ciborg971/Devterm-Custom-EXT/boardTop.PNG

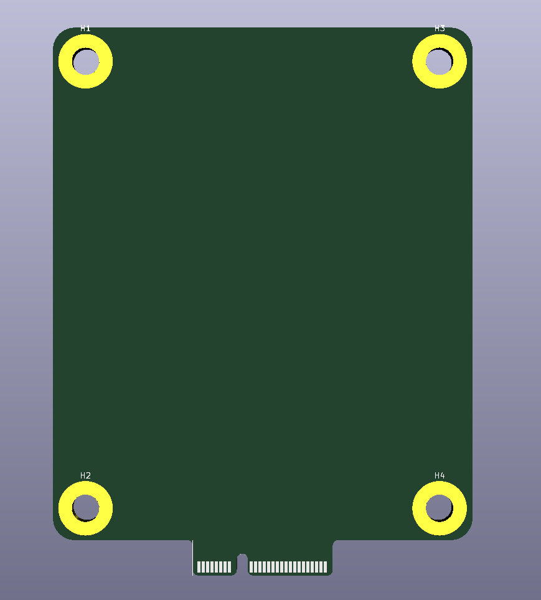
boardTop.PNG
