ciborg971/Devterm-Custom-EXT/DOC/6f06c1a4455e24246e7014514f4f96971abfcb94.png

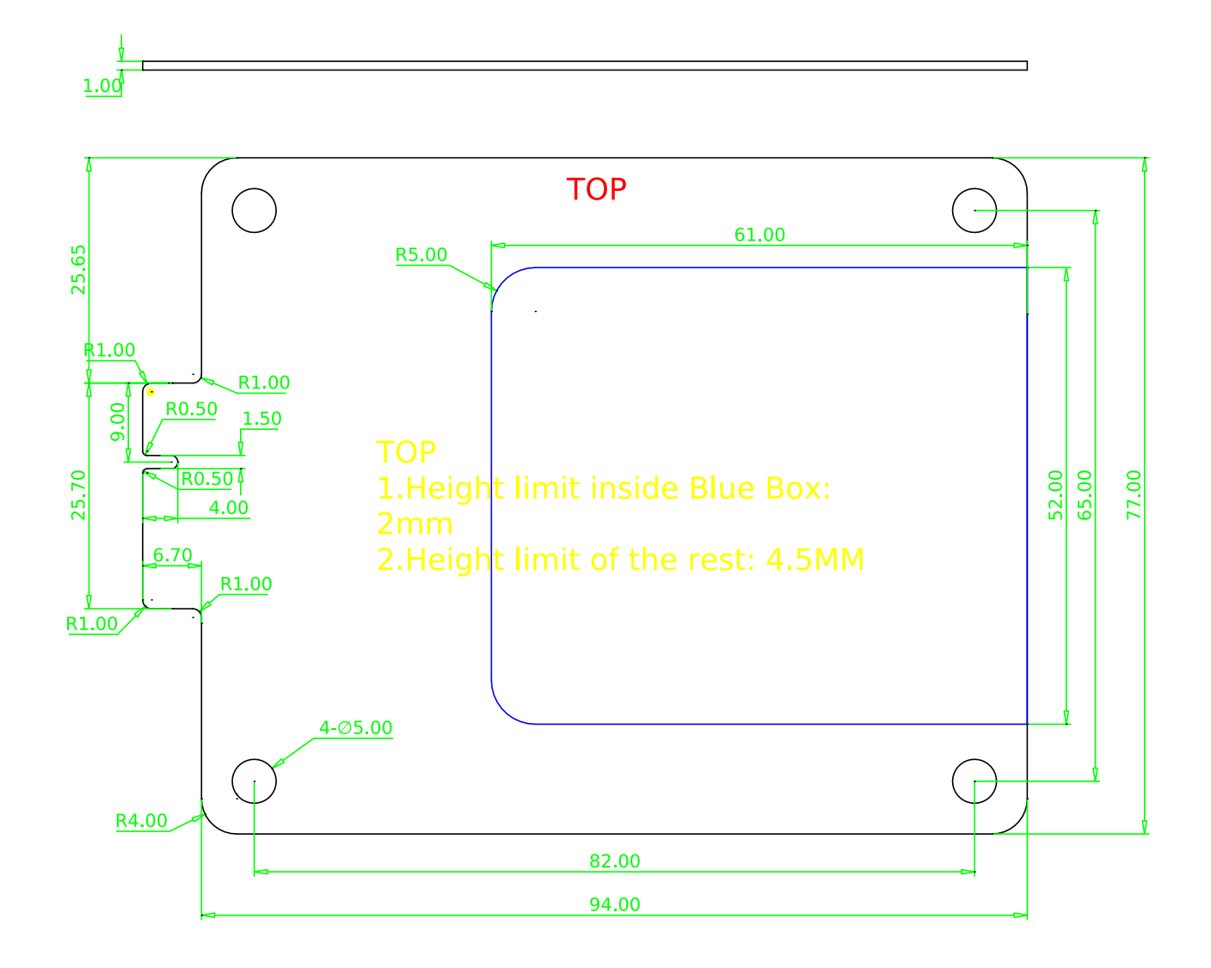
DOC/6f06c1a4455e24246e7014514f4f96971abfcb94.png
