ciborg971/Devterm-Custom-EXT/DOC/45b9404a094dcbd29ee0b0e9fbe9222e9d59b63e.png

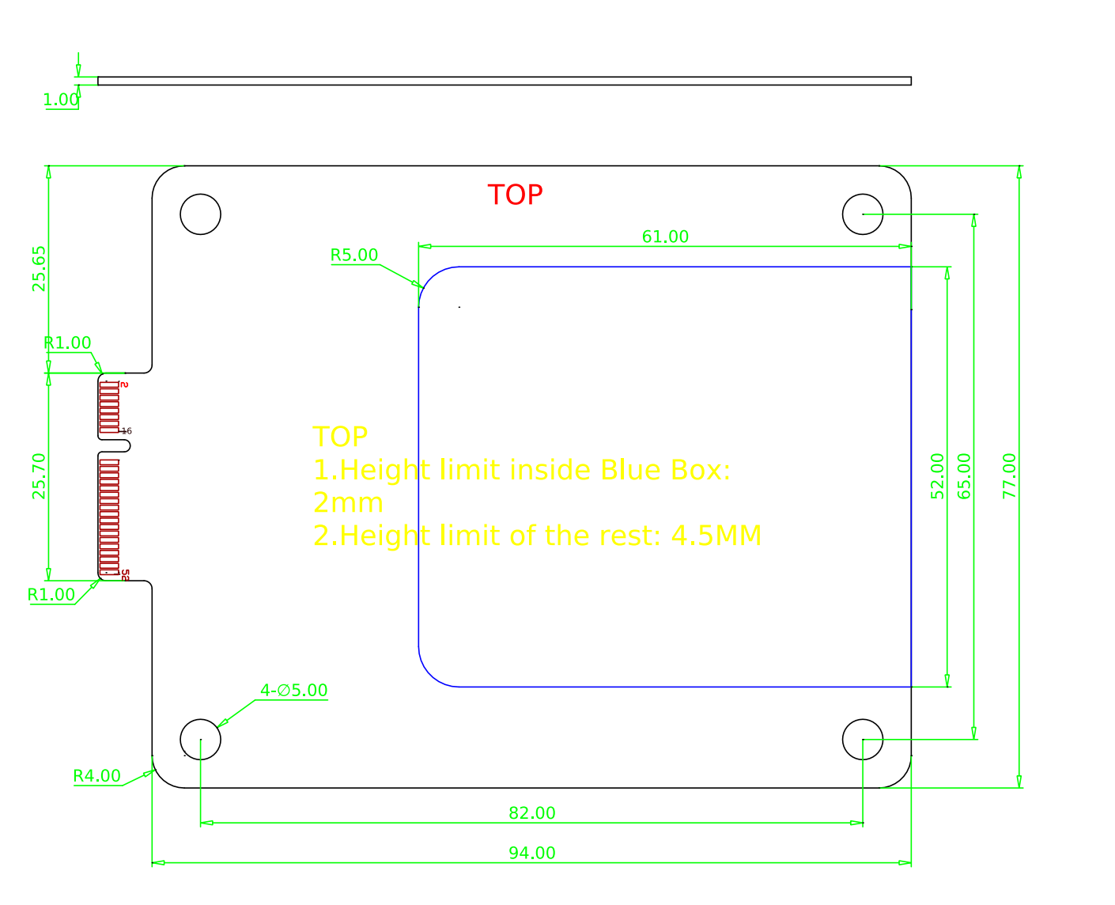
DOC/45b9404a094dcbd29ee0b0e9fbe9222e9d59b63e.png
