ciborg971/Devterm-Custom-EXT/DOC/df499cc8dd050f36cda59deae903229f311af123.png

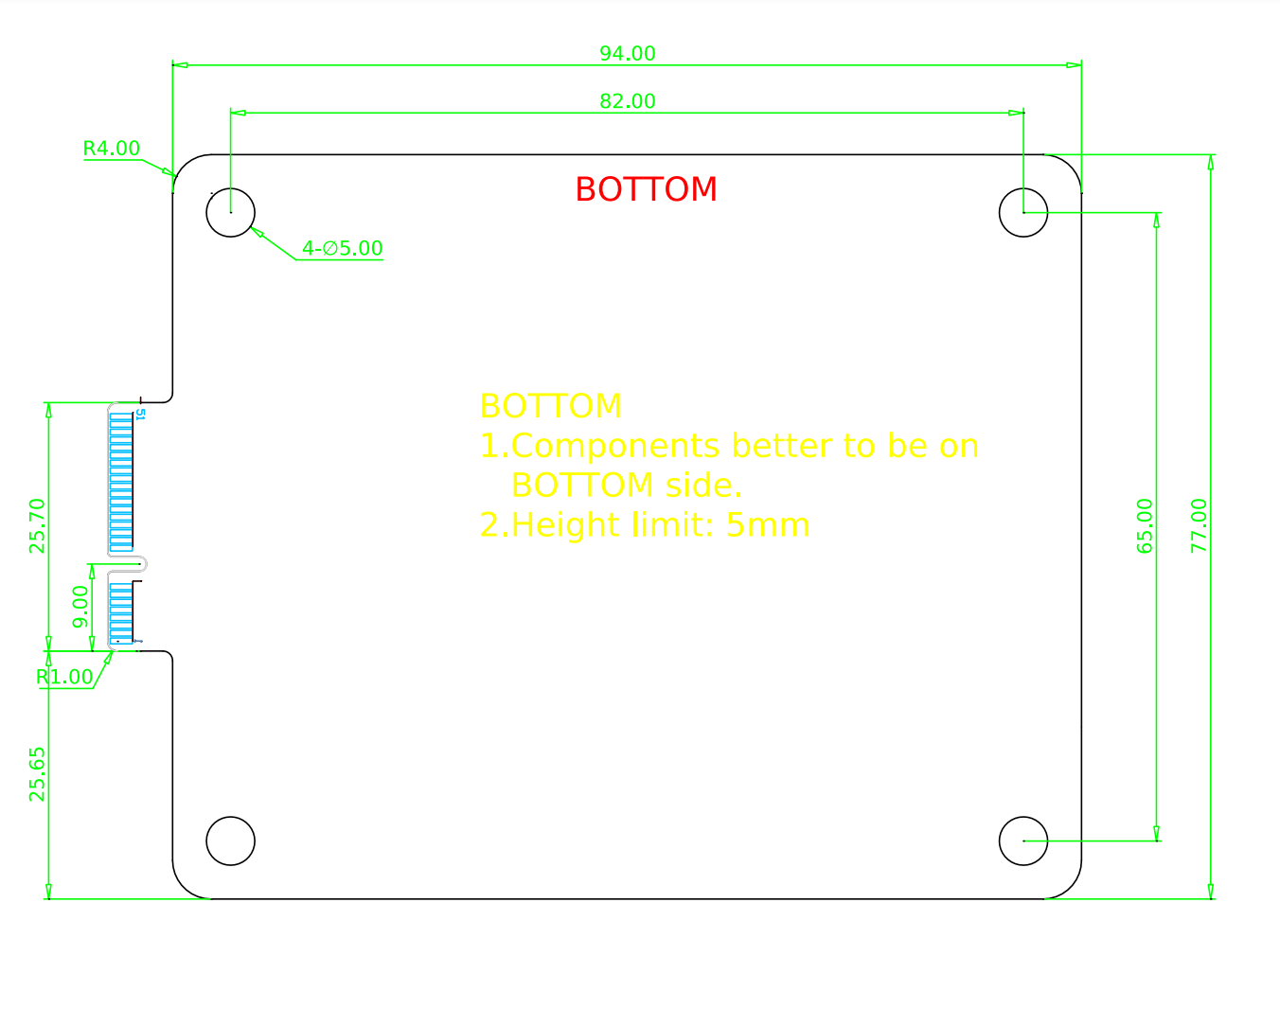
DOC/df499cc8dd050f36cda59deae903229f311af123.png
