ciborg971/Devterm-Custom-EXT/DCEXT/output/Schematic.pdf

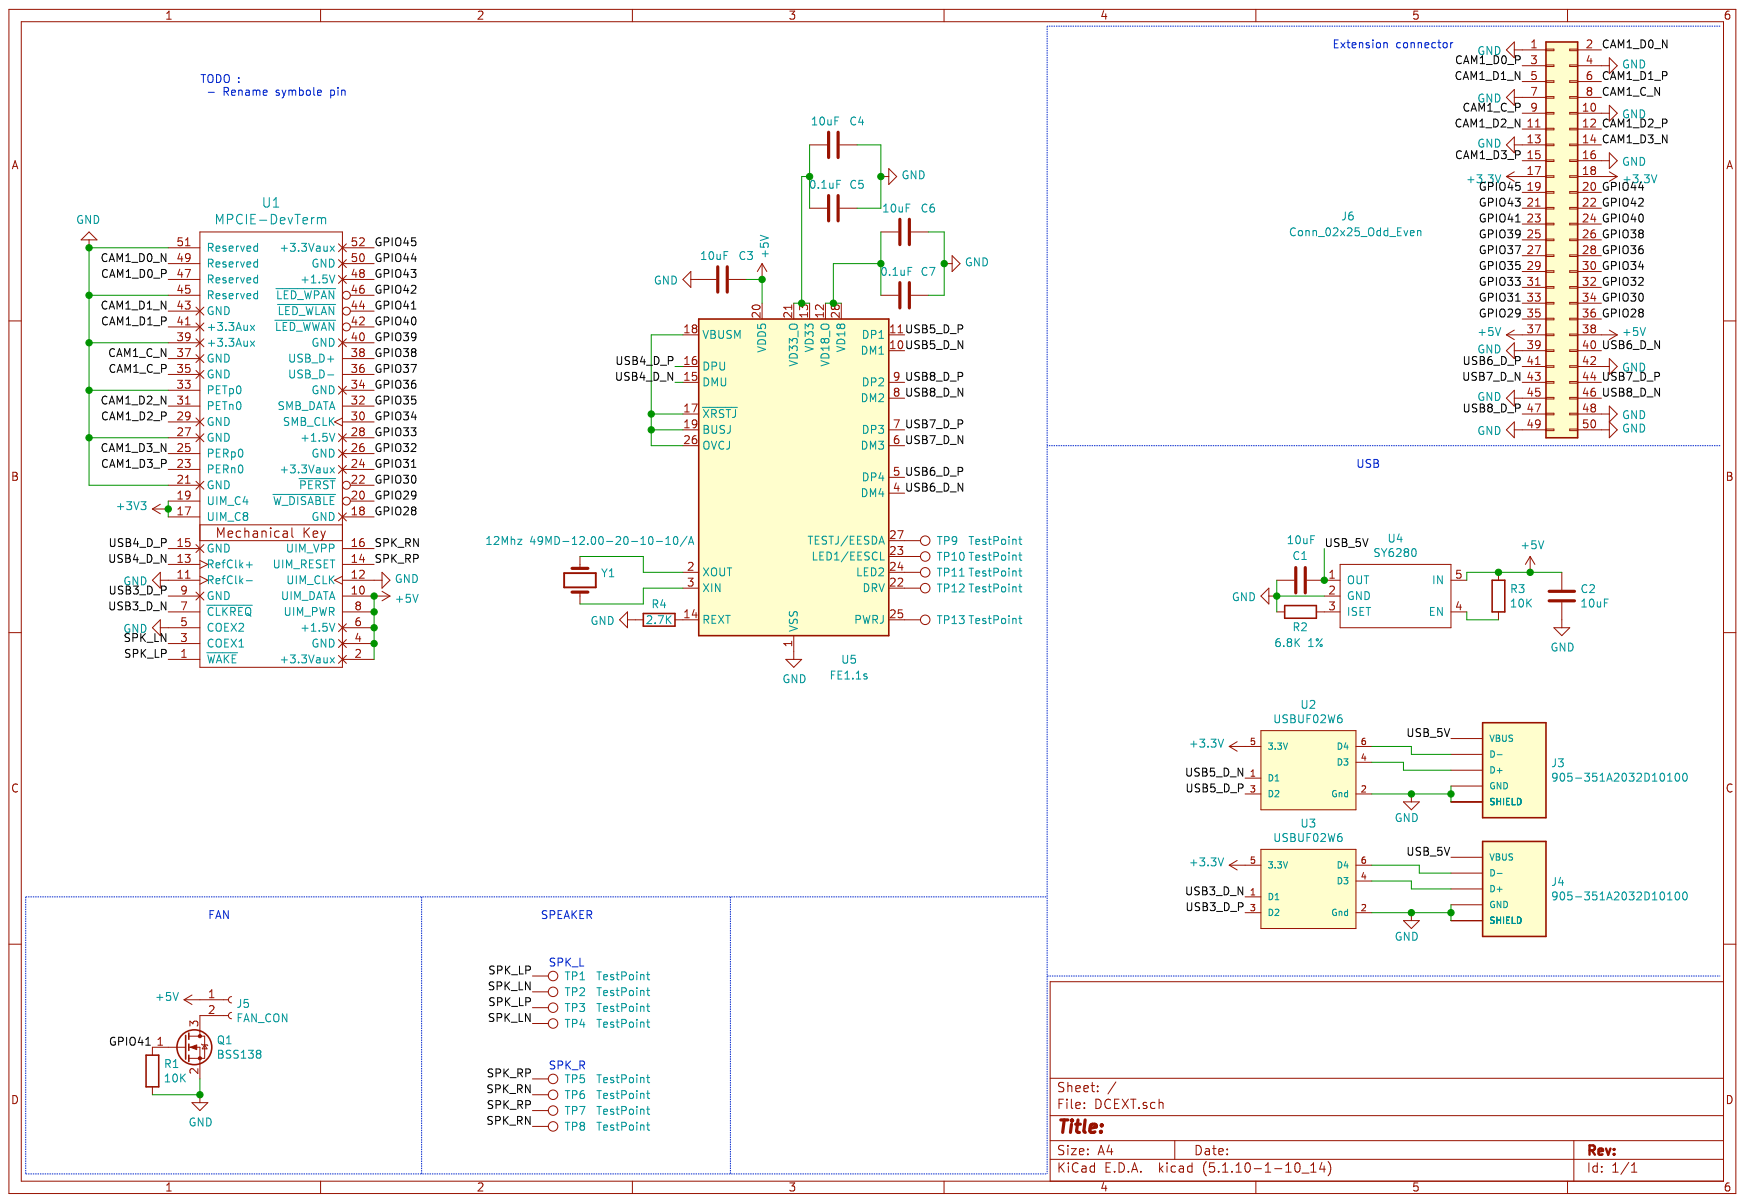
[picture p5: page 1]
