ciborg971/Devterm-Custom-EXT/DCEXT/DCEXT.kicad_pcb

## KiCad design DCEXT/DCEXT.kicad_pcb (2021-12-01)

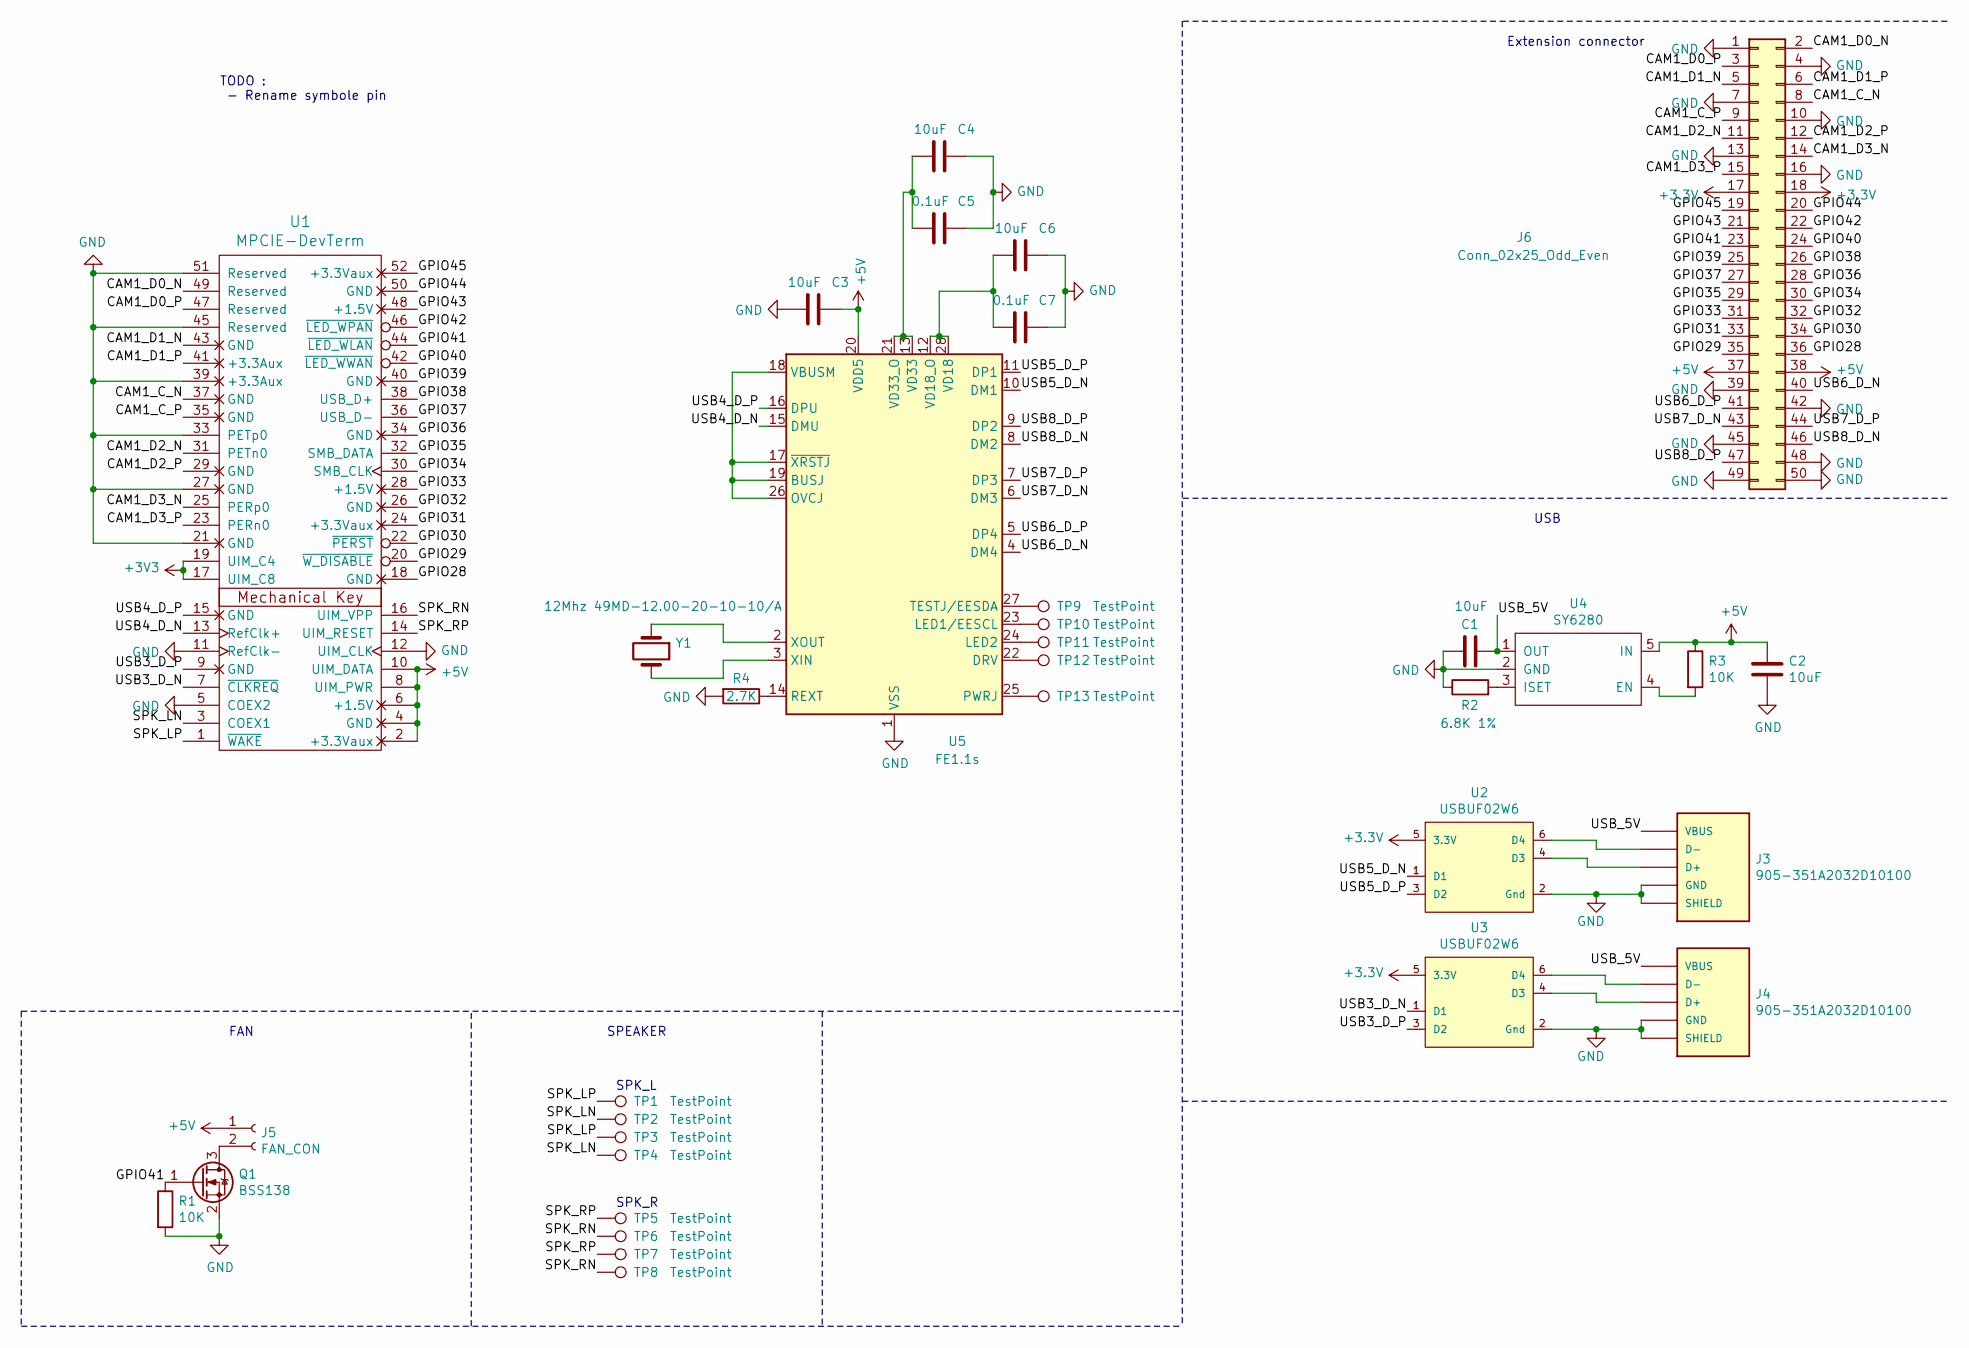
[picture p6: schematic DCEXT.sch]

Parts:
C1, C2, C3, C4, C6: 10uF; C_0402_1005Metric; LCSC C2846677
C5, C7: 0.1uF; C_0402_1005Metric; LCSC C41851
J3, J4: 905-351A2032D10100; USB-A-TH_USB-M-55-F; LCSC C42623
J5: FAN_CON; JST_PH_S2B-PH-K_1x02_P2.00mm_Horizontal; LCSC C160237
J6: Conn_02x25_Odd_Even; Hirose_FH12-50S-0.5SH_1x50-1MP_P0.50mm_Horizontal; LCSC C11098
Q1: BSS138; SOT-23; LCSC C427380
R1, R3: 10K; R_0402_1005Metric; LCSC C258091
R2: 6.8K 1%; R_0402_1005Metric; LCSC C208929
R4: 2.7K; R_0402_1005Metric; LCSC C168220
TP1, TP2, TP3, TP4, TP5, TP6, TP7, TP8: TestPoint; TestPoint_Pad_3.0x3.0mm
TP9, TP10, TP11, TP12, TP13: TestPoint; TestPoint_Pad_1.5x1.5mm
U1: MPCIE-DevTerm; devtermMPCIE
U2, U3: USBUF02W6; ST_Microelectronics-USBUF02W6-0; mouser part number 511-USBUF02W6; digikey description RC (Pi) EMI Filter 2nd Order Low Pass 2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
U4: SY6280; SOT-23-5_HandSoldering; LCSC C55136
U5: FE1.1s; SSOP-28_3.9x9.9mm_P0.635mm; LCSC C9359
Y1: 12Mhz 49MD-12.00-20-10-10/A; Crystal_SMD_HC49-SD; LCSC C240992

Connections:
+5V: C2.1, C3.1, J5.1, J6.37, J6.38, R3.1, U1.2 (+3.3Vaux), U1.4 (GND), U1.6 (+1.5V), U1.8 (UIM_PWR), U1.10 (UIM_DATA), U4.5 (IN), U5.20 (VDD5)
/CAM1_C_N: J6.8, U1.37 (GND)
/CAM1_C_P: J6.9, U1.35 (GND)
/CAM1_D0_N: J6.2, U1.49 (Reserved)
/CAM1_D0_P: J6.3, U1.47 (Reserved)
/CAM1_D1_N: J6.5, U1.43 (GND)
/CAM1_D1_P: J6.6, U1.41 (+3.3Aux)
/CAM1_D2_N: J6.11, U1.31 (PETn0)
/CAM1_D2_P: J6.12, U1.29 (GND)
/CAM1_D3_N: J6.14, U1.25 (PERp0)
/CAM1_D3_P: J6.15, U1.23 (PERn0)
/GPIO28: J6.36, U1.18 (GND)
/GPIO29: J6.35, U1.20 (~W_DISABLE)
/GPIO30: J6.34, U1.22 (~PERST)
/GPIO31: J6.33, U1.24 (+3.3Vaux)
/GPIO32: J6.32, U1.26 (GND)
/GPIO33: J6.31, U1.28 (+1.5V)
/GPIO34: J6.30, U1.30 (SMB_CLK)
/GPIO35: J6.29, U1.32 (SMB_DATA)
/GPIO36: J6.28, U1.34 (GND)
/GPIO37: J6.27, U1.36 (USB_D-)
/GPIO38: J6.26, U1.38 (USB_D+)
/GPIO39: J6.25, U1.40 (GND)
/GPIO40: J6.24, U1.42 (~LED_WWAN)
/GPIO41: J6.23, Q1.1 (G), R1.1, U1.44 (~LED_WLAN)
/GPIO42: J6.22, U1.46 (~LED_WPAN)
/GPIO43: J6.21, U1.48 (+1.5V)
/GPIO44: J6.20, U1.50 (GND)
/GPIO45: J6.19, U1.52 (+3.3Vaux)
/SPK_LN: TP2.1, TP4.1, U1.3 (COEX1)
/SPK_LP: TP1.1, TP3.1, U1.1 (~WAKE)
/SPK_RN: TP6.1, TP8.1, U1.16 (UIM_VPP)
/SPK_RP: TP5.1, TP7.1, U1.14 (UIM_RESET)
/USB3_D_N: U1.7 (~CLKREQ), U3.1 (D1)
/USB3_D_P: U1.9 (GND), U3.3 (D2)
/USB4_D_N: U1.13 (RefClk+), U5.15 (DMU)
/USB4_D_P: U1.15 (GND), U5.16 (DPU)
/USB5_D_N: U2.1 (D1), U5.10 (DM1)
/USB5_D_P: U2.3 (D2), U5.11 (DP1)
/USB6_D_N: J6.40, U5.4 (DM4)
/USB6_D_P: J6.41, U5.5 (DP4)
/USB7_D_N: J6.43, U5.6 (DM3)
/USB7_D_P: J6.44, U5.7 (DP3)
/USB8_D_N: J6.46, U5.8 (DM2)
/USB8_D_P: J6.47, U5.9 (DP2)
/USB_5V: C1.2, J3.1 (VBUS), J4.1 (VBUS), U4.1 (OUT)
GND: C1.1, C2.2, C3.2, C4.1, C5.1, C6.1, C7.1, J3.4 (GND), J3.5 (SHIELD), J3.6 (SHIELD), J3.7 (SHIELD), J3.8 (SHIELD), J4.4 (GND), J4.5 (SHIELD), J4.6 (SHIELD), J4.7 (SHIELD), J4.8 (SHIELD), J6.1, J6.4, J6.7, J6.10, J6.13, J6.16, J6.39, J6.42, J6.45, J6.48, J6.49, J6.50, Q1.2 (S), R1.2, R2.1, R4.2, U1.5 (COEX2), U1.11 (RefClk-), U1.12 (UIM_CLK), U1.21 (GND), U1.27 (GND), U1.33 (PETp0), U1.39 (+3.3Aux), U1.45 (Reserved), U1.51 (Reserved), U2.2 (Gnd), U3.2 (Gnd), U4.2 (GND), U5.1 (VSS)
unnamed: C4.2, C5.2, U5.13 (VD33), U5.21 (VD33_O)
unnamed: C6.2, C7.2, U5.12 (VD18_O), U5.28 (VD18)
unnamed: J3.2 (D-), U2.6 (D4)
unnamed: J3.3 (D+), U2.4 (D3)
unnamed: J4.2 (D-), U3.6 (D4)
unnamed: J4.3 (D+), U3.4 (D3)
unnamed: J5.2, Q1.3 (D)
unnamed: R2.2, U4.3 (ISET)
unnamed: R3.2, U4.4 (EN)
unnamed: R4.1, U5.14 (REXT)
unnamed: TP9.1, U5.27 (TESTJ/EESDA)
unnamed: TP10.1, U5.23 (LED1/EESCL)
unnamed: TP11.1, U5.24 (LED2)
unnamed: TP12.1, U5.22 (DRV)
unnamed: TP13.1, U5.25 (PWRJ)
unnamed: U5.2 (XOUT), Y1.1
unnamed: U5.3 (XIN), Y1.2
unnamed: U5.17 (~XRSTJ), U5.18 (VBUSM), U5.19 (BUSJ), U5.26 (OVCJ)

Notes on the sheet:
FAN
SPEAKER
USB
TODO : - Rename symbole pin
Extension connector
SPK_L
SPK_R

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
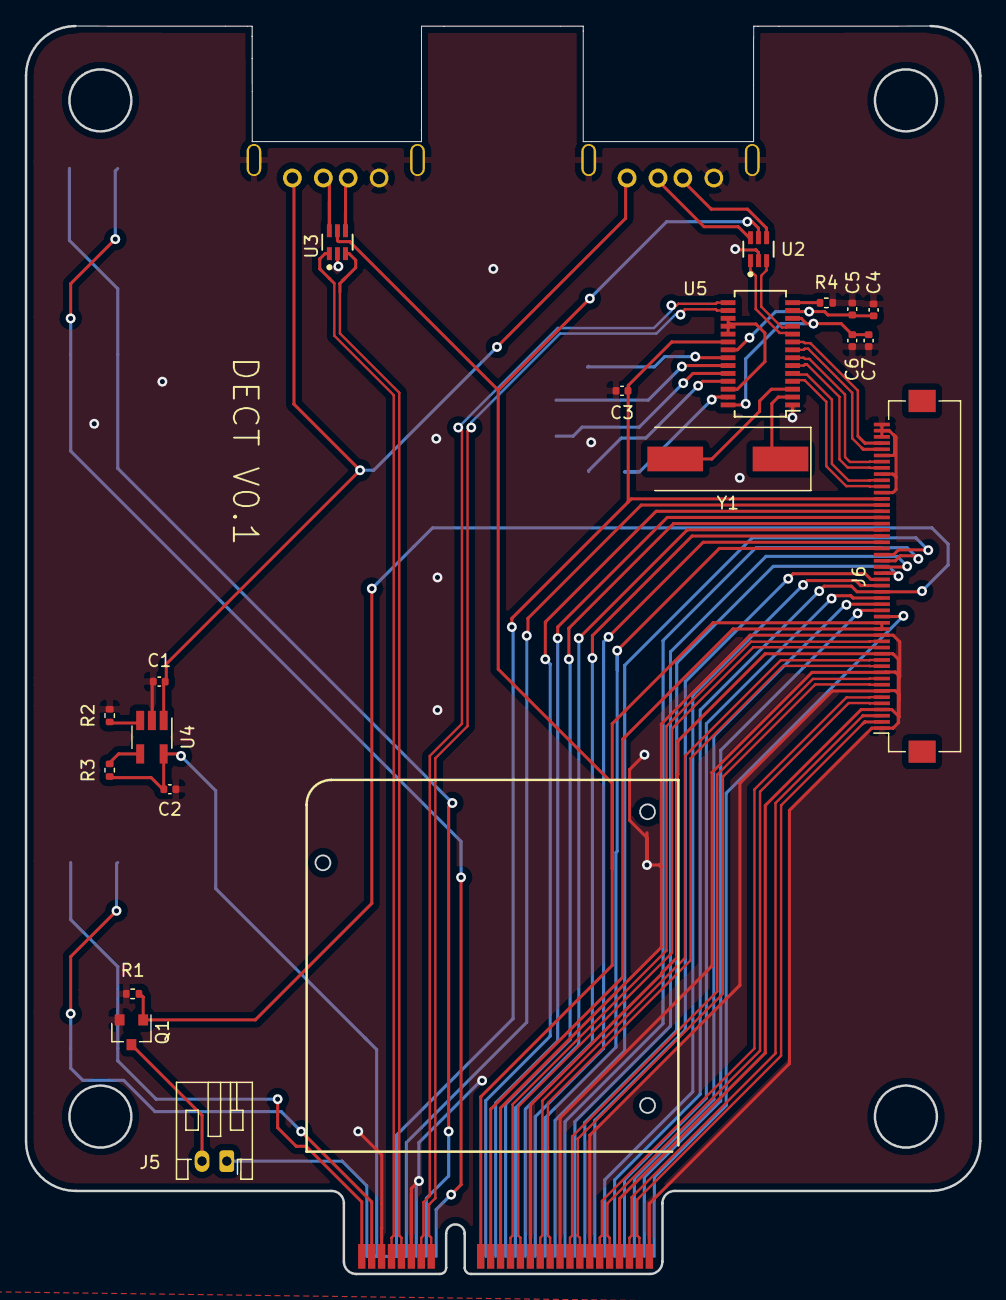
[picture p7: board DCEXT.kicad_pcb from above]

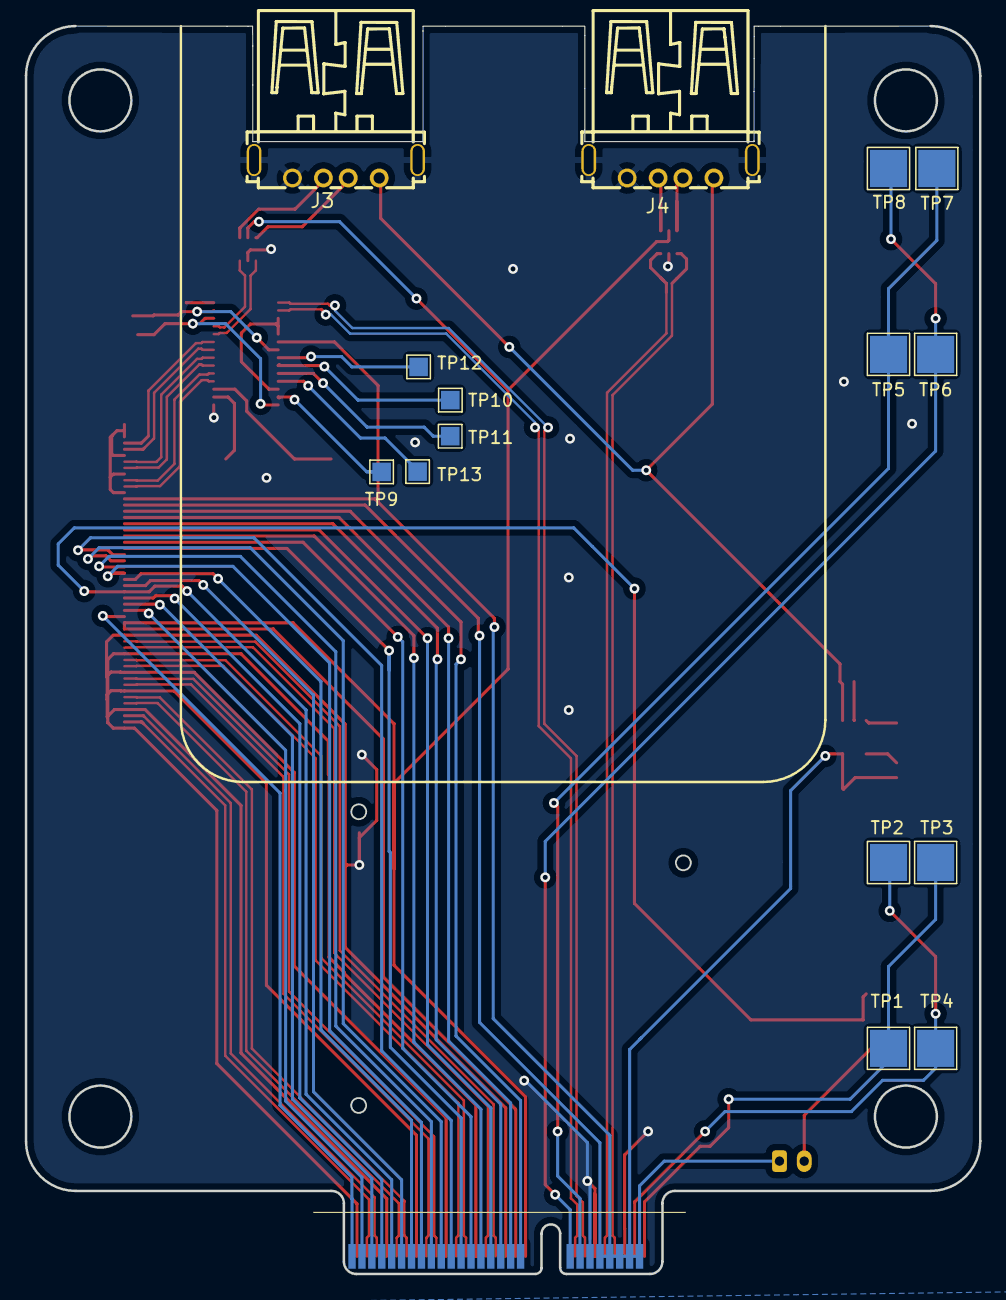
[picture p8: board DCEXT.kicad_pcb from below]

Board: 2 copper layers, 77.0 x 100.7 mm, 35 parts (15 on the bottom side), 66 nets.
