ciborg971/Devterm-Custom-EXT/(commit log)

2021-09-12 Add pcb outline, mpcie connector and holes (hole position is not accurate)
    [DCEXT.kicad_pcb, DCEXT.sch]
2021-09-12 Add usb host connector and add more documentation
    [DCEXT.kicad_pcb, DCEXT.sch]
2021-09-12 Add usb protection, fan control and fpc connector for module
    [DCEXT.kicad_pcb, DCEXT.sch]
2021-09-14 Update schematic of original EXT module (compoment value), add reference dxf file
2021-09-14 Add updated dxf from clockwork and converted it for kicad
    Tutorial to convert a dxf to kicad format ; https://github.com/KiCad/kicad-doc/blob/master/src/pcbnew/pcbnew_create_and_modify_board.adoc
2021-09-14 Fix usb position,holes and pcb outline, add current limiter
    [DCEXT.kicad_pcb, DCEXT.sch]
2021-09-15 Progess
    Pop OS and kicad decided i didnt need 3d acceleration anymore, switching to mac
    [DCEXT.kicad_pcb, DCEXT.sch]
2021-11-13 Fix usb position (for the last time !), speaker connector and routing
    [DCEXT.kicad_pcb, DCEXT.sch]
2021-11-13 Add USB hub, routing and start part sourcing
    Spoiller alert : everything is out of stock ...
    [DCEXT.kicad_pcb, DCEXT.sch]
2021-12-01 Change USB connector to something in stock :/ + gerber files
    [DCEXT-B_Cu.gbl, DCEXT-B_Mask.gbs, DCEXT-B_Paste.gbp, DCEXT-B_SilkS.gbo, DCEXT-Edge_Cuts.gm1, DCEXT-F_Cu.gtl, DCEXT-F_Mask.gts, DCEXT-F_Paste.gtp]
